FKlugmann/FreeDeck-deej-combo/Freedeck_Screen_Solderguide.STL

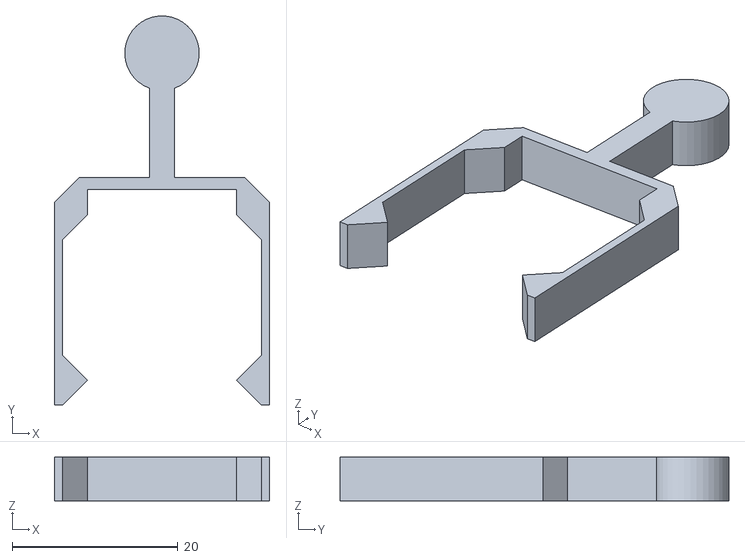
[picture p1: CAD file, 2021-07-10]
Freedeck_Screen_Solderguide.STL
26.0 x 47.0 x 5.30
