FKlugmann/FreeDeck-deej-combo/Housing_STL_data/Fader_knob_oversize.STL

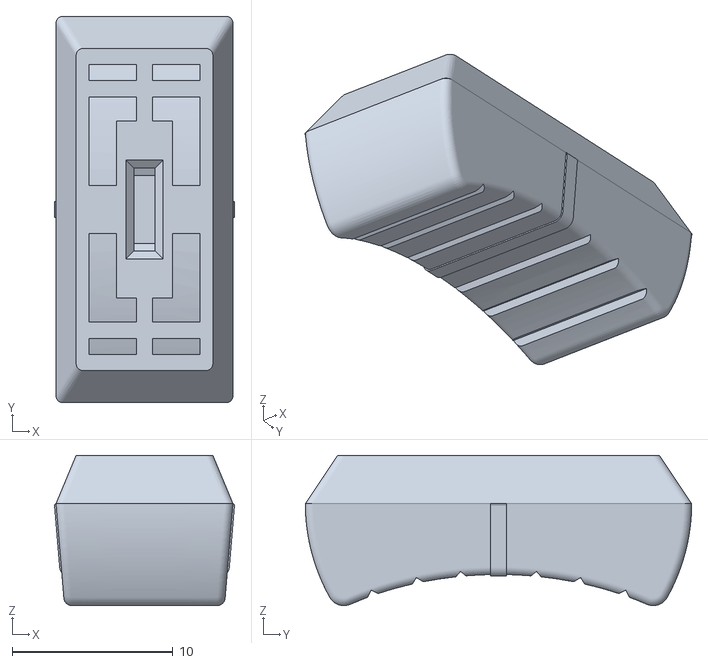
[picture p2: CAD file, 2021-07-07]
Housing_STL_data/Fader_knob_oversize.STL
11.2 x 24.0 x 9.33
