FKlugmann/FreeDeck-deej-combo/Housing_STL_data/Freedeck_8_deej_4_encoder_knob.STL

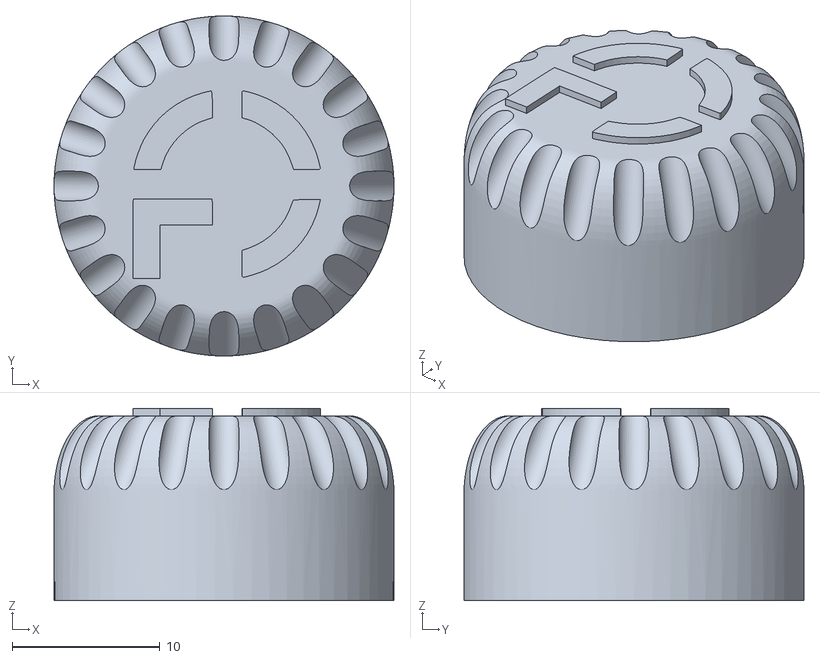
[picture p3: CAD file, 2021-07-07]
Housing_STL_data/Freedeck_8_deej_4_encoder_knob.STL
23.0 x 23.0 x 13.0
