FKlugmann/FreeDeck-deej-combo/Housing_STL_data/Freedeck_8_deej_4_Housing_Bottom.STL

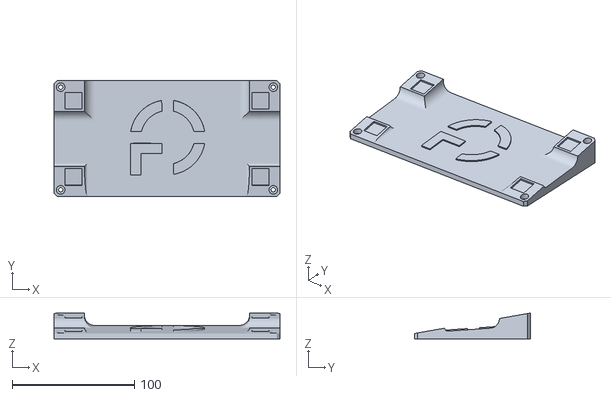
[picture p4: CAD file, 2021-07-07]
Housing_STL_data/Freedeck_8_deej_4_Housing_Bottom.STL
185.0 x 95.0 x 21.3
