FKlugmann/FreeDeck-deej-combo/Housing_STL_data/Freedeck_8_deej_4_Housing_Top.STL

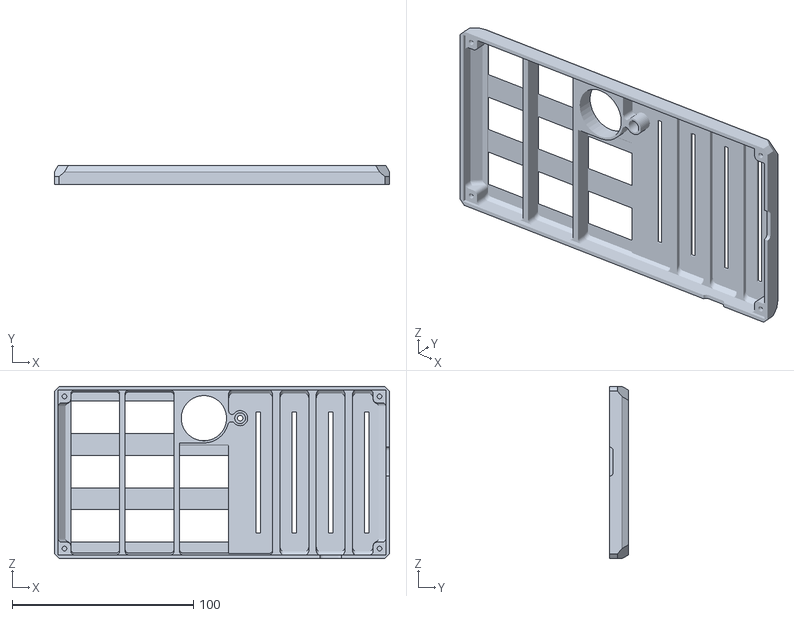
[picture p5: CAD file, 2021-07-07]
Housing_STL_data/Freedeck_8_deej_4_Housing_Top.STL
185.0 x 10.5 x 95.0
