FKlugmann/FreeDeck-deej-combo/(list of files, cad)

Other CAD files:
Housing_STL_data/Fader_knob_normalfit.STL
Housing_STL_data/Fader_knob_undersize.STL
