FKlugmann/FreeDeck-deej-combo/FreeDeck_deej_combo_circuit_diagram.pdf

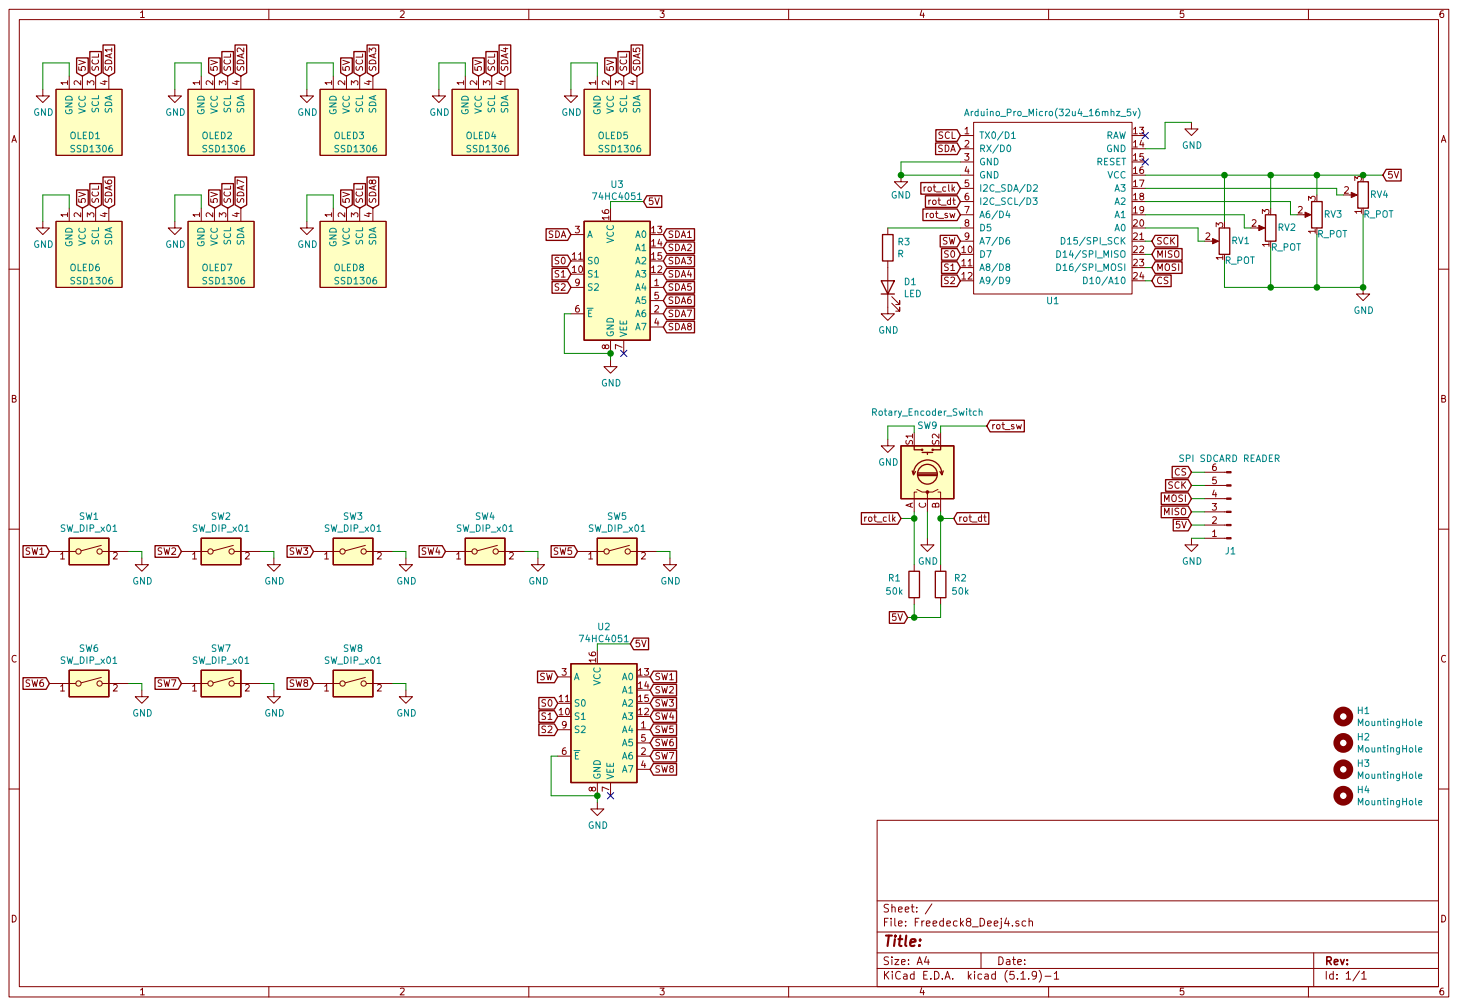
[picture p49: page 1]

1 VCC
J1 SPI SDCARD READER GND

4 OLED5 SSD1306 TX0/D1 1 D7 10 A8/D8 11 A9/D9 12 RAW 13 GND 14 RESET 15 VCC 16 A3 17 A2 18 A1 19 RX/D0 2 A0 20 D15/SPI_SCK 21 D14/SPI_MISO 22 D16/SPI_MOSI 23 D10/A10 24 GND 3 GND 4

SCK MISO MOSI CS
