FKlugmann/FreeDeck-deej-combo/(commit log)

2021-07-07 Create Folder Housing
2021-07-07 Adding Housing STL files
    [Fader_knob_normalfit.STL, Fader_knob_oversize.STL, Fader_knob_undersize.STL, Freedeck_8_deej_4_Housing_Bottom.STL, Freedeck_8_deej_4_Housing_Top.STL, Freedeck_8_deej_4_encoder_knob.STL]
2021-07-07 Add Gerber files
2021-07-10 Add Solderguide
    [Freedeck_Screen_Solderguide.STL]
2021-07-13 Added circuit diagram
