FKlugmann/FreeDeck-deej-combo/(notices)

Notices in the files:
Modified_Freedeck_Firmware/app/app.ino:
modify it under the terms of the GNU General Public License as published by
the Free Software Foundation, either version 3 of the License,
or (at your option) any later version.
